Jin-Neuron/EleMagHarmony/Hardware/F303K8/EleMagDriver/pic/v3.0/schematic.jpg

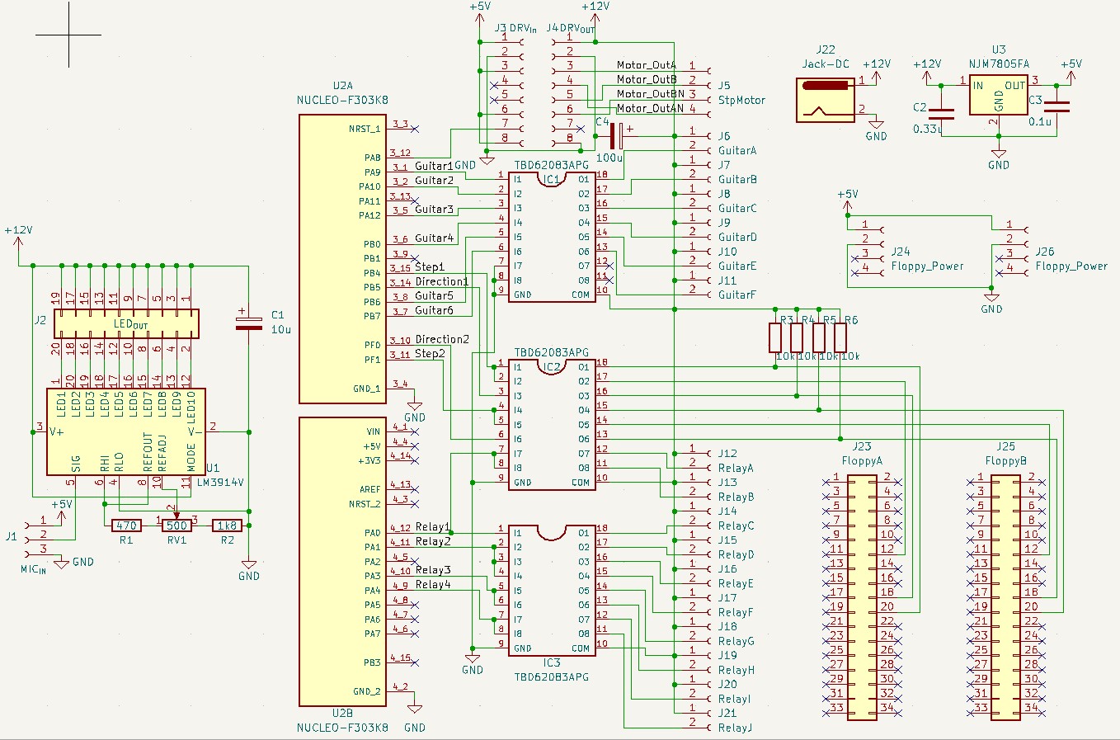
Hardware/F303K8/EleMagDriver/pic/v3.0/schematic.jpg
