Jin-Neuron/EleMagHarmony/Hardware/F303K8/F303K8PinOut/Board.jpg

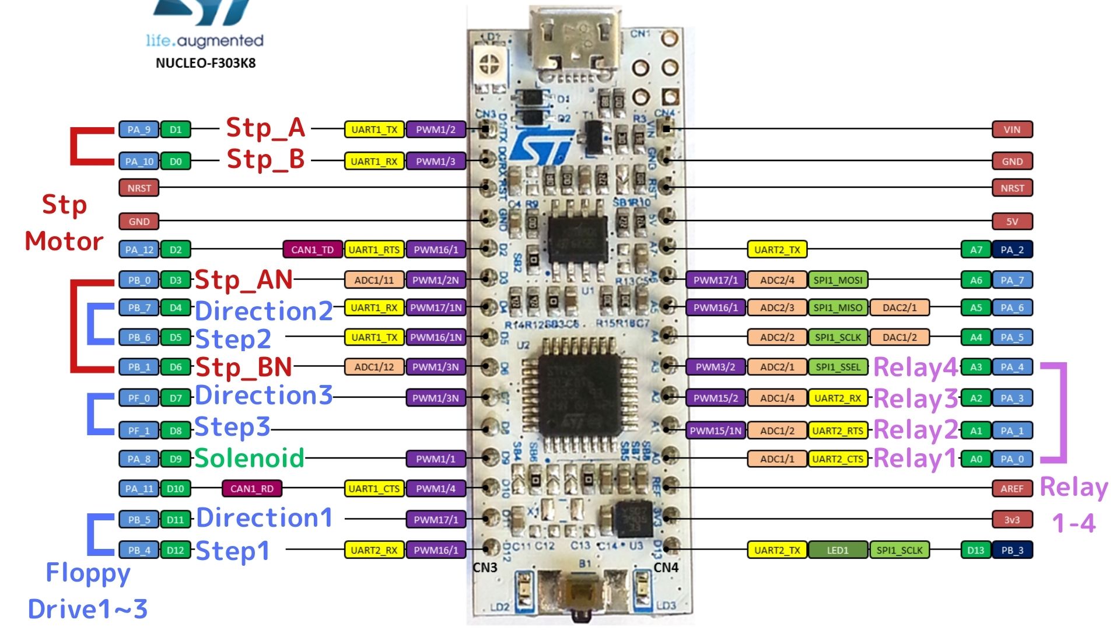
Hardware/F303K8/F303K8PinOut/Board.jpg
