Jin-Neuron/EleMagHarmony/Hardware/F303K8/F303K8PinOut/MCU.jpg

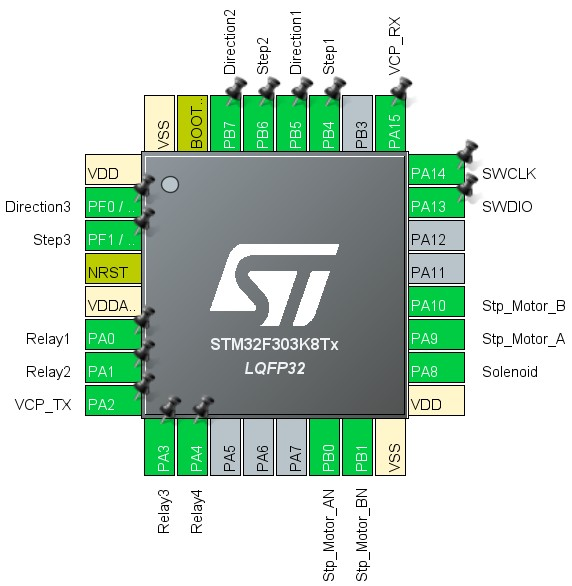
Hardware/F303K8/F303K8PinOut/MCU.jpg
