Jin-Neuron/EleMagHarmony/Hardware/F401RE/F401REPinOut/Left.jpg

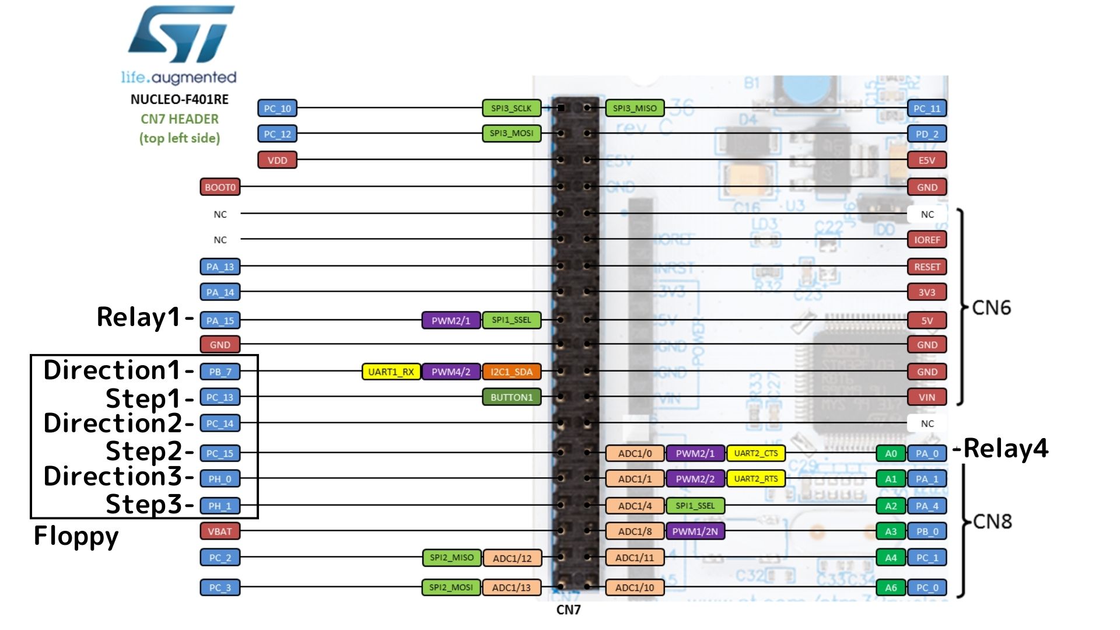
Hardware/F401RE/F401REPinOut/Left.jpg
