Jin-Neuron/EleMagHarmony/Hardware/F401RE/F401REPinOut/MCU.jpg

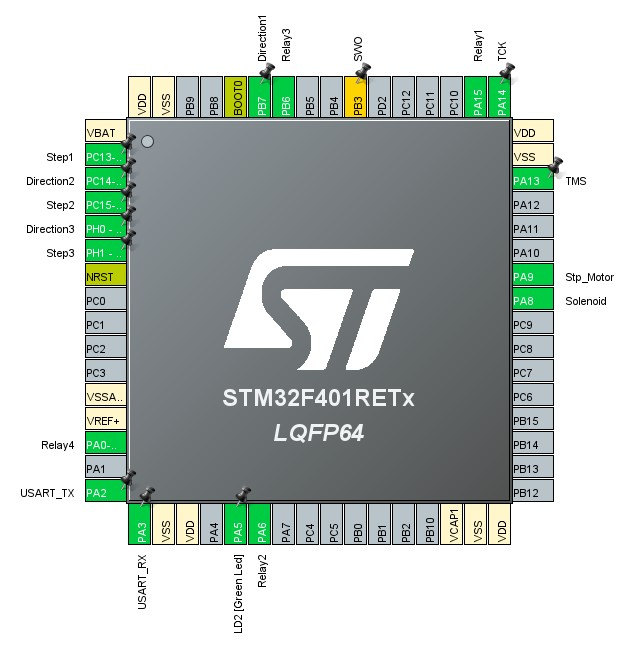
Hardware/F401RE/F401REPinOut/MCU.jpg
