Jin-Neuron/EleMagHarmony/Hardware/F401RE/F401REPinOut/Right.jpg

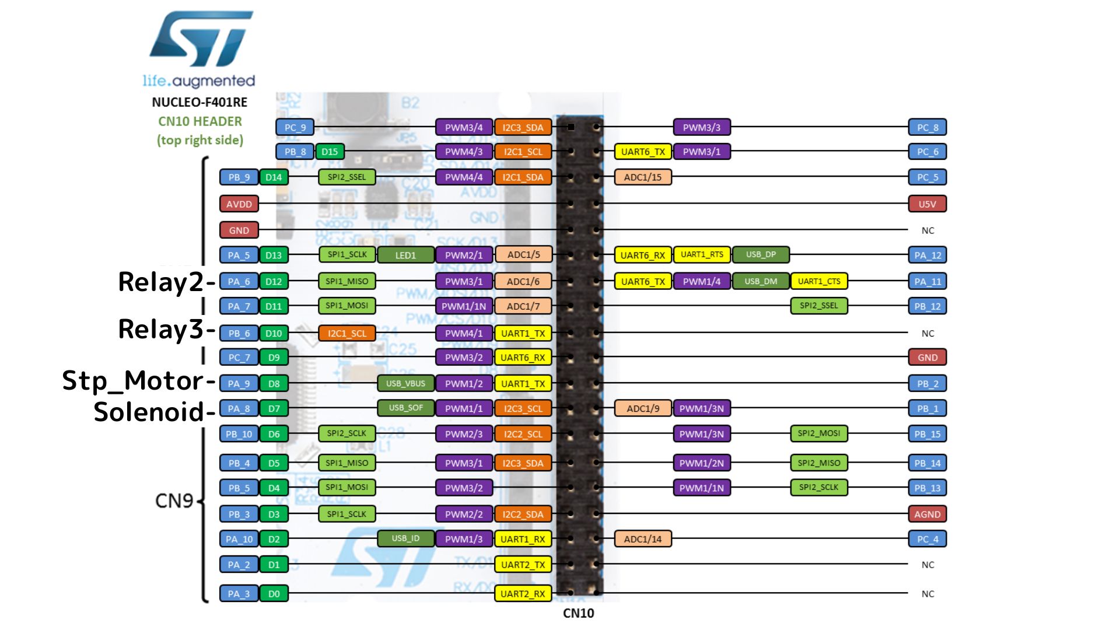
Hardware/F401RE/F401REPinOut/Right.jpg
