Jin-Neuron/EleMagHarmony/pic/Guitar.jpg

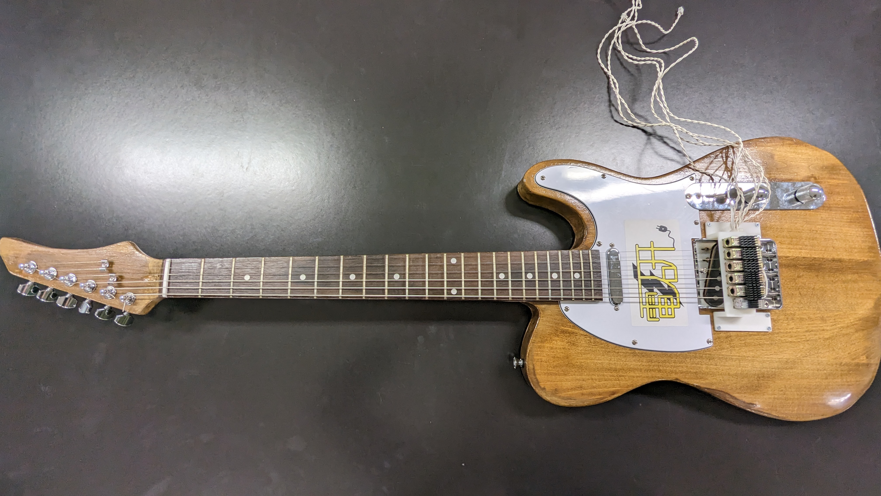
pic/Guitar.jpg
