Jin-Neuron/EleMagHarmony/Hardware/Guitar/SolenoidMount.stl

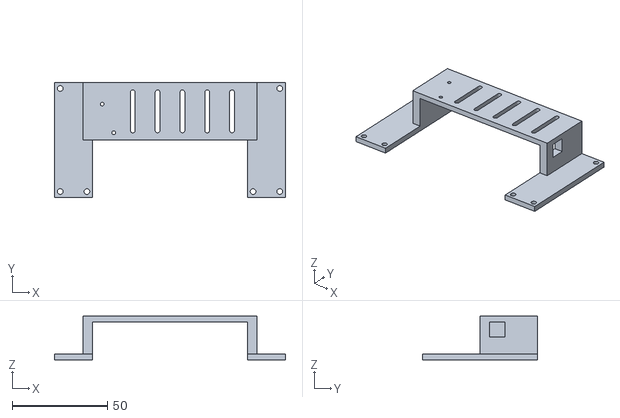
[picture p13: CAD file, 2023-10-04]
Hardware/Guitar/SolenoidMount.stl
121.0 x 60.0 x 23.0
