Jin-Neuron/EleMagHarmony/Hardware/F303K8/EleMagDriver/EleMagDriver.kicad_pcb

## KiCad design Hardware/F303K8/EleMagDriver/EleMagDriver.kicad_pcb (2023-10-03)

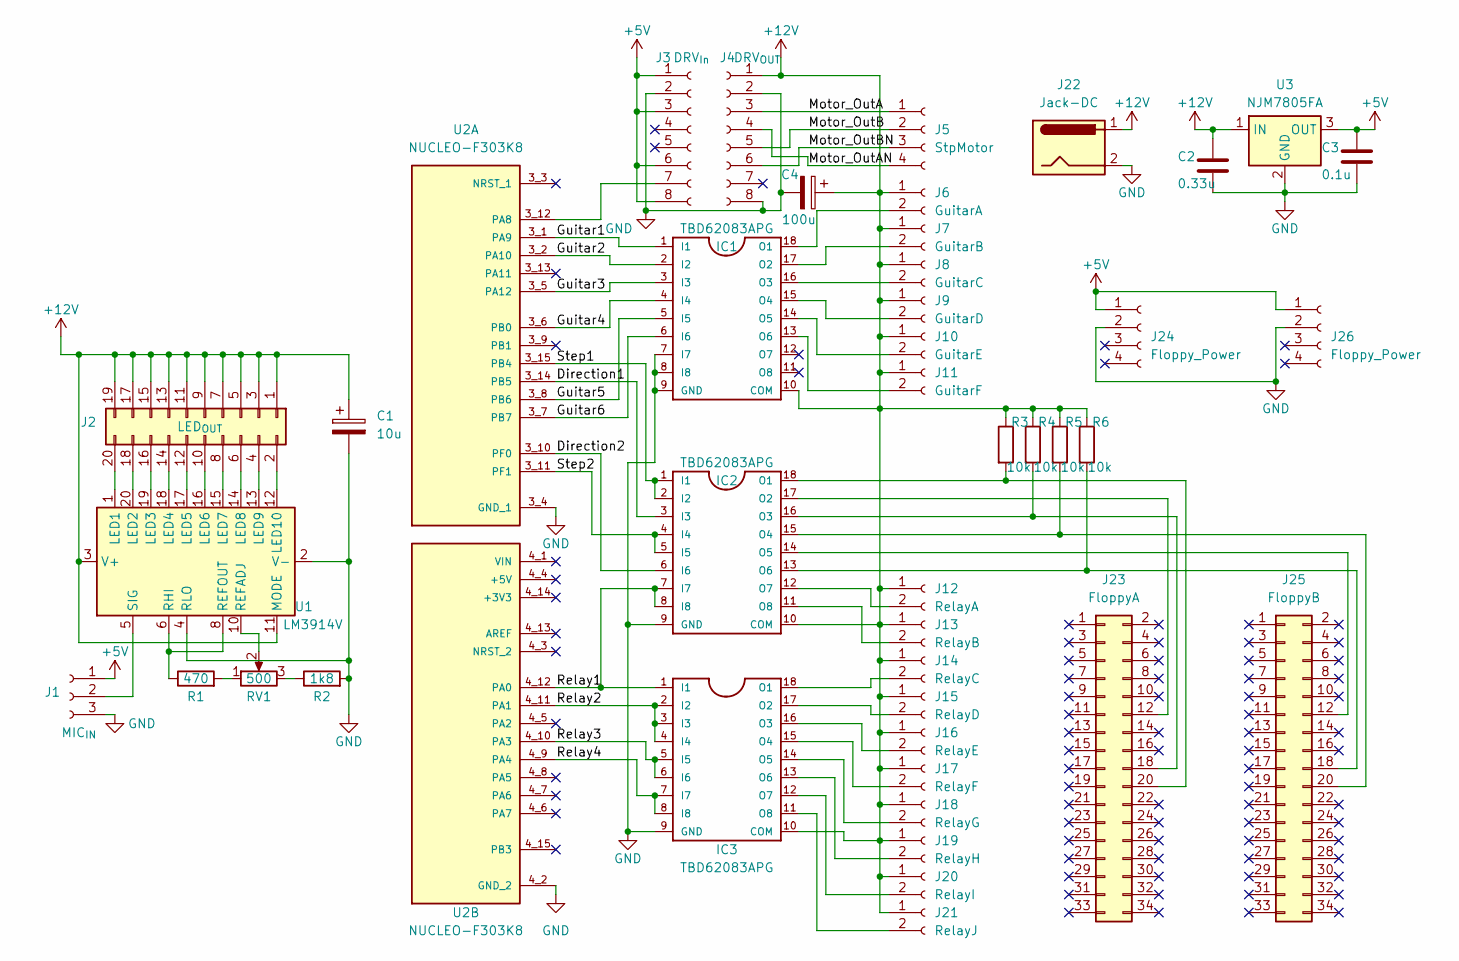
[picture p14: schematic EleMagDriver.kicad_sch]

Parts:
C1: 10u; CP_Radial_D5.0mm_P2.00mm
C2: 0.33u; C_Disc_D4.7mm_W2.5mm_P5.00mm
C3: 0.1u; C_Disc_D4.7mm_W2.5mm_P5.00mm
C4: 100u; CP_Radial_D6.3mm_P2.50mm
IC1, IC2, IC3: TBD62083APG; DIP-18_W7.62mm
J1: MIC_{IN}; PinSocket_1x03_P2.54mm_Vertical
J2: LED_{OUT}; PinHeader_2x10_P2.54mm_Vertical
J3: DRV_{In}; PinSocket_1x08_P2.54mm_Vertical
J4: DRV_{OUT}; PinSocket_1x08_P2.54mm_Vertical
J5: StpMotor; JST_XH_S4B-XH-A_1x04_P2.50mm_Horizontal
J6: GuitarA; JST_XH_S2B-XH-A_1x02_P2.50mm_Horizontal
J7: GuitarB; JST_XH_S2B-XH-A_1x02_P2.50mm_Horizontal
J8: GuitarC; JST_XH_S2B-XH-A_1x02_P2.50mm_Horizontal
J9: GuitarD; JST_XH_S2B-XH-A_1x02_P2.50mm_Horizontal
J10: GuitarE; JST_XH_S2B-XH-A_1x02_P2.50mm_Horizontal
J11: GuitarF; JST_XH_S2B-XH-A_1x02_P2.50mm_Horizontal
J12: RelayA; JST_XH_B2B-XH-A_1x02_P2.50mm_Vertical
J13: RelayB; JST_XH_B2B-XH-A_1x02_P2.50mm_Vertical
J14: RelayC; JST_XH_B2B-XH-A_1x02_P2.50mm_Vertical
J15: RelayD; JST_XH_B2B-XH-A_1x02_P2.50mm_Vertical
J16: RelayE; JST_XH_B2B-XH-A_1x02_P2.50mm_Vertical
J17: RelayF; JST_XH_B2B-XH-A_1x02_P2.50mm_Vertical
J18: RelayG; JST_XH_B2B-XH-A_1x02_P2.50mm_Vertical
J19: RelayH; JST_XH_B2B-XH-A_1x02_P2.50mm_Vertical
J20: RelayI; JST_XH_B2B-XH-A_1x02_P2.50mm_Vertical
J21: RelayJ; JST_XH_B2B-XH-A_1x02_P2.50mm_Vertical
J22: Jack-DC; BarrelJack_Horizontal
J23: FloppyA; SHDR34W70P254_2X17_5050X820X900P
J24, J26: Floppy_Power; PinHeader_1x04_P2.54mm_Horizontal
J25: FloppyB; SHDR34W70P254_2X17_5050X820X900P
R1: 470; R_Axial_DIN0207_L6.3mm_D2.5mm_P10.16mm_Horizontal
R2: 1k8; R_Axial_DIN0207_L6.3mm_D2.5mm_P10.16mm_Horizontal
R3, R4, R5, R6: 10k; R_Axial_DIN0207_L6.3mm_D2.5mm_P10.16mm_Horizontal
RV1: 500; Potentiometer_Bourns_3386P_Vertical
U1: LM3914V; PLCC-20
U2: NUCLEO-F303K8; MODULE_NUCLEO-F303K8; PARTREV 5
U3: NJM7805FA; TO-220-3_Vertical

Connections:
+5V: C3.1, J1.1, J3.1, J3.3, J3.6, J3.8, J24.1, J26.1, U3.3 (OUT)
+12V: C1.1, C2.1, C4.1, IC1.10 (COM), IC2.10 (COM), IC3.10 (COM), J2.1, J2.3, J2.5, J2.7, J2.9, J2.11, J2.13, J2.15, J2.17, J2.19, J4.1, J6.1, J7.1, J8.1, J9.1, J10.1, J11.1, J12.1, J13.1, J14.1, J15.1, J16.1, J17.1, J18.1, J19.1, J20.1, J21.1, J22.1, R3.1, R4.1, R5.1, R6.1, U1.3 (V+), U1.11 (MODE), U3.1 (IN)
/Direction1: IC2.3 (I3), U2.3_14 (PB5)
/Direction2: IC2.6 (I6), U2.3_10 (PF0)
/Guitar1: IC1.1 (I1), U2.3_1 (PA9)
/Guitar2: IC1.2 (I2), U2.3_2 (PA10)
/Guitar3: IC1.3 (I3), U2.3_5 (PA12)
/Guitar4: IC1.4 (I4), U2.3_6 (PB0)
/Guitar5: IC1.5 (I5), U2.3_8 (PB6)
/Guitar6: IC1.6 (I6), U2.3_7 (PB7)
/Motor_OutA: J4.3, J5.1
/Motor_OutAN: J4.4, J5.4
/Motor_OutB: J4.5, J5.2
/Motor_OutBN: J4.6, J5.3
/Relay1: IC2.7 (I7), IC2.8 (I8), IC3.1 (I1), U2.4_12 (PA0)
/Relay2: IC3.2 (I2), IC3.3 (I3), IC3.4 (I4), U2.4_11 (PA1)
/Relay3: IC3.5 (I5), IC3.6 (I6), U2.4_10 (PA3)
/Relay4: IC3.7 (I7), IC3.8 (I8), U2.4_9 (PA4)
/Step1: IC2.1 (I1), IC2.2 (I2), U2.3_15 (PB4)
/Step2: IC2.4 (I4), IC2.5 (I5), U2.3_11 (PF1)
GND: C1.2, C2.2, C3.2, C4.2, IC1.7 (I7), IC1.8 (I8), IC1.9 (GND), IC2.9 (GND), IC3.9 (GND), J1.3, J3.2, J4.2, J4.8, J22.2, J24.2, J26.2, R2.2, U1.2 (V-), U1.4 (RLO), U2.3_4 (GND_1), U2.4_2 (GND_2), U3.2 (GND)
unnamed: IC1.18 (O1), J6.2
unnamed: IC1.17 (O2), J7.2
unnamed: IC1.16 (O3), J8.2
unnamed: IC1.15 (O4), J9.2
unnamed: IC1.14 (O5), J10.2
unnamed: IC1.13 (O6), J11.2
unnamed: IC2.18 (O1), J23.20, R3.2
unnamed: IC2.17 (O2), J23.12
unnamed: IC2.16 (O3), J23.18, R4.2
unnamed: IC2.15 (O4), J25.20, R5.2
unnamed: IC2.14 (O5), J25.12
unnamed: IC2.13 (O6), J25.18, R6.2
unnamed: IC2.12 (O7), J12.2
unnamed: IC2.11 (O8), J13.2
unnamed: IC3.18 (O1), J14.2
unnamed: IC3.17 (O2), J15.2
unnamed: IC3.16 (O3), J16.2
unnamed: IC3.15 (O4), J17.2
unnamed: IC3.14 (O5), J18.2
unnamed: IC3.13 (O6), J19.2
unnamed: IC3.12 (O7), J20.2
unnamed: IC3.11 (O8), J21.2
unnamed: J1.2, U1.5 (SIG)
unnamed: J2.2, U1.12 (LED10)
unnamed: J2.4, U1.13 (LED9)
unnamed: J2.6, U1.14 (LED8)
unnamed: J2.8, U1.15 (LED7)
unnamed: J2.10, U1.16 (LED6)
unnamed: J2.12, U1.17 (LED5)
unnamed: J2.14, U1.18 (LED4)
unnamed: J2.16, U1.19 (LED3)
unnamed: J2.18, U1.20 (LED2)
unnamed: J2.20, U1.1 (LED1)
unnamed: J3.7, U2.3_12 (PA8)
unnamed: R1.2, RV1.1
unnamed: R2.1, RV1.3
unnamed: RV1.2, U1.10 (REFADJ)
unnamed: R1.1, U1.6 (RHI), U1.8 (REFOUT)

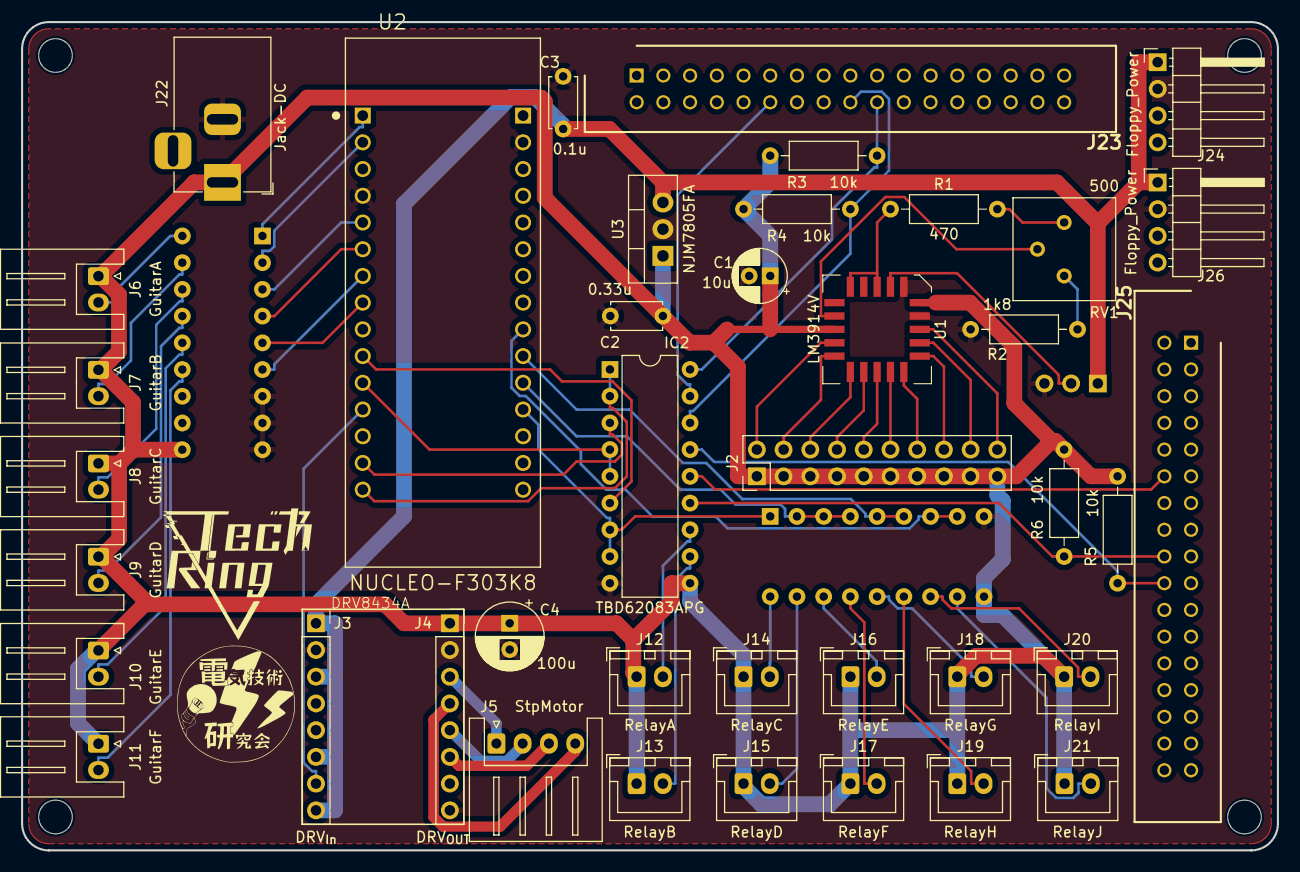
[picture p15: board EleMagDriver.kicad_pcb from above]

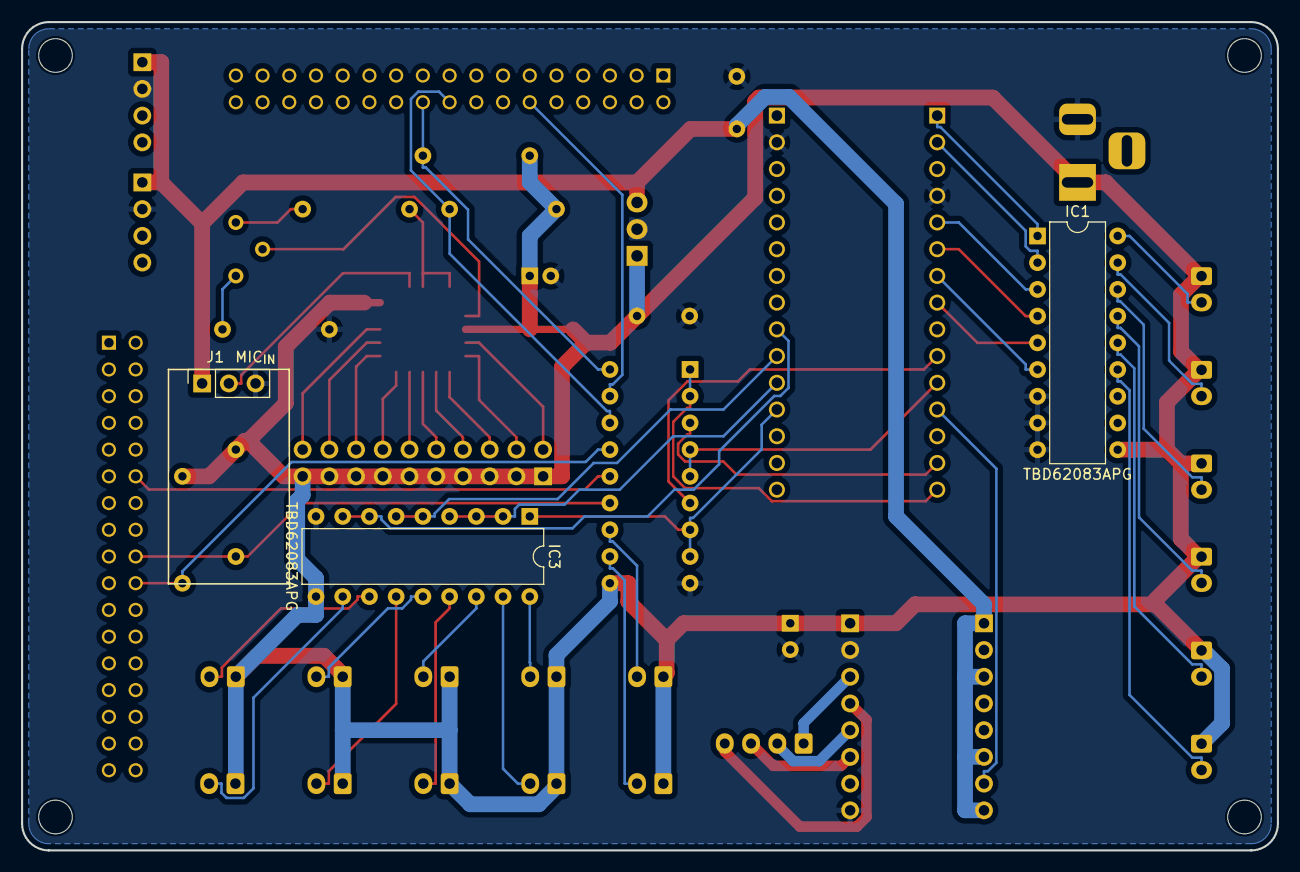
[picture p16: board EleMagDriver.kicad_pcb from below]

Board: 2 copper layers, 119.4 x 78.7 mm, 45 parts (3 on the bottom side), 59 nets.

Other parts of the board:
G0: LOGO; TechRing
G1: LOGO; Denken
