Jin-Neuron/EleMagHarmony/Hardware/F303K8/EleMagDriver/SoundLevelMater/SoundLevelMater.kicad_pcb

## KiCad design Hardware/F303K8/EleMagDriver/SoundLevelMater/SoundLevelMater.kicad_pcb (2023-08-28)

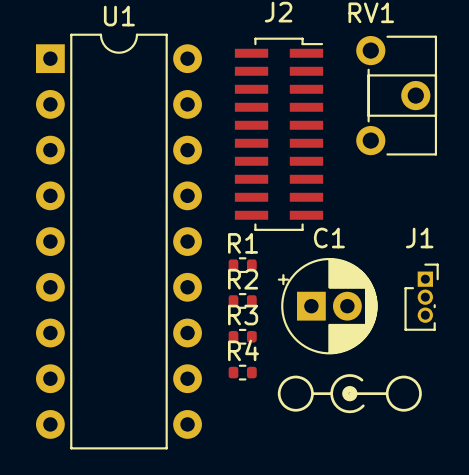
[picture p17: board SoundLevelMater.kicad_pcb from above]

Board: 2 copper layers, 10 parts (0 on the bottom side), 8 nets, no tracks yet.

Parts:
C1: C_Polarized; CP_Radial_D5.0mm_P2.00mm
J1: Conn_01x03_Socket; PinSocket_1x03_P1.00mm_Vertical
J2: Conn_02x10_Row_Letter_Last; PinSocket_2x10_P1.00mm_Vertical_SMD
J3: Barrel_Jack; Symbol_Barrel_Polarity
R1, R2, R3, R4: R; R_0402_1005Metric
RV1: R_Potentiometer; Potentiometer_ACP_CA6-H2,5_Horizontal
U1: LM3914N; DIP-18_W7.62mm

Connections:
+5V: C1.1, J1.1, U1.3 (V+), U1.9 (MODE)
GND: C1.2, J1.2, R3.2, R4.2, U1.2 (V-), U1.4 (RLO)
unnamed: J1.3, R2.1
unnamed: R1.2, RV1.1
unnamed: R3.1, RV1.3
unnamed: RV1.2, U1.8 (REFADJ)
unnamed: R1.1, U1.6 (RHI), U1.7 (REFOUT)
unnamed: R2.2, R4.1, U1.5 (SIG)
