Jin-Neuron/EleMagHarmony/Hardware/F401RE/401REFirm/Core/Src/main.c

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
/* Includes ------------------------------------------------------------------*/
#include "main.h"

/* USER CODE BEGIN Includes */
#include <math.h>
#include <stdlib.h>
/* USER CODE END Includes */

/* USER CODE BEGIN PD */
#define TimerNum 8
#define FloppyNum 6
/* USER CODE END PD */

TIM_HandleTypeDef htim1;
TIM_HandleTypeDef htim2;
TIM_HandleTypeDef htim3;
TIM_HandleTypeDef htim4;
TIM_HandleTypeDef htim5;
TIM_HandleTypeDef htim9;
TIM_HandleTypeDef htim10;
TIM_HandleTypeDef htim11;

UART_HandleTypeDef huart2;

/* USER CODE BEGIN PV */
GPIO_PinState currentState = GPIO_PIN_RESET;
uint8_t currentPosition = 0;
uint8_t isTimer1Counting = 0;

char dataLength[8];
char data[255];
char length[10];
uint8_t uartCnt = 0;
uint64_t dataLen;
uint16_t notes[10] = {0};
uint16_t freqs[10] = {0};
double tmp[10] = {0};

const double timer_clock = 84e6;
const uint8_t timerPeriod = 100;

uint8_t arrayLen = 0;
GPIO_TypeDef* floppyPort[FloppyNum] = {};
uint32_t floppyPin[FloppyNum] = {};
TIM_HandleTypeDef times[TimerNum] = {};
/* USER CODE END PV */

void SystemClock_Config(void);
static void MX_GPIO_Init(void);
static void MX_USART2_UART_Init(void);
static void MX_TIM1_Init(void);
static void MX_TIM2_Init(void);
static void MX_TIM3_Init(void);
static void MX_TIM4_Init(void);
static void MX_TIM5_Init(void);
static void MX_TIM9_Init(void);
static void MX_TIM10_Init(void);
static void MX_TIM11_Init(void);
/* USER CODE BEGIN 0 */

//reset position of floppy
void resetStep(){
	for(uint8_t i = 0; i < FloppyNum; i+=2){
		//i : Direction, i+1 : Step
		LL_GPIO_SetOutputPin(floppyPort[i], floppyPin[i]);
		for(uint8_t j = 0; j < 79; j++){
			LL_GPIO_SetOutputPin(floppyPort[i+1], floppyPin[i+1]);
			LL_GPIO_ResetOutputPin(floppyPort[i+1], floppyPin[i+1]);
		}
		currentPosition = 0;
		LL_GPIO_ResetOutputPin(floppyPort[i], floppyPin[i]);
	}
}


//Timer interrupt (floppy control only)
void HAL_TIM_PeriodElapsedCallback(TIM_HandleTypeDef *htim)
{
	uint8_t timerIdx = 0;
	for(; timerIdx < TimerNum; timerIdx++){
		if(htim == &times[timerIdx])
			break;
	}
	if(timerIdx >= 5){
		//Update position
		//timer : 5 --> floppy : 0, 1
		//timer : 6 --> floppy : 2, 3
		//timer : 7 --> floppy : 4, 5
		if(currentState == GPIO_PIN_SET){
			if(--currentPosition <= 0){
				currentState = GPIO_PIN_RESET;
				LL_GPIO_ResetOutputPin(floppyPort[(timerIdx - 5) * 2], floppyPin[(timerIdx - 5) * 2]);
			}
		}else if(++currentPosition >= 158){
			currentState = GPIO_PIN_SET;
			LL_GPIO_SetOutputPin(floppyPort[(timerIdx - 5) * 2], floppyPin[(timerIdx - 5) * 2]);
		}
		LL_GPIO_TogglePin(floppyPort[(timerIdx - 5) * 2 + 1], floppyPin[(timerIdx - 5) * 2 + 1]);
	}
}

//Set frequency of Timer
void setTimer(uint8_t part, TIM_HandleTypeDef htim, uint32_t prescaler){

  if(prescaler < 0) prescaler = 799;

  htim.Instance = htim.Instance;
  htim.Init.Prescaler = prescaler;
  htim.Init.CounterMode = TIM_COUNTERMODE_UP;
  htim.Init.Period = timerPeriod - 1;	//because of start with 0
  htim.Init.ClockDivision = TIM_CLOCKDIVISION_DIV1;

	if(part < 5){
		TIM_OC_InitTypeDef sConfigOC = {0};	//pwm setting only
	  HAL_TIM_PWM_Init(&htim);

	  sConfigOC.OCMode = TIM_OCMODE_PWM1;
	  sConfigOC.Pulse = 50;
	  //set duty
	  sConfigOC.OCPolarity = TIM_OCPOLARITY_HIGH;
	  sConfigOC.OCFastMode = TIM_OCFAST_DISABLE;
	  sConfigOC.OCIdleState = TIM_OCIDLESTATE_RESET;
	  sConfigOC.OCNIdleState = TIM_OCNIDLESTATE_RESET;
	  HAL_TIM_PWM_ConfigChannel(&htim, &sConfigOC, TIM_CHANNEL_1);
	  HAL_TIM_PWM_ConfigChannel(&htim, &sConfigOC, TIM_CHANNEL_2);

	  //start
	  HAL_TIM_PWM_Start(&htim, TIM_CHANNEL_1);
	  HAL_TIM_PWM_Start(&htim, TIM_CHANNEL_2);	//stp_motor only

	}else{
	  HAL_TIM_Base_Init(&htim);
	  // start
	  HAL_TIM_Base_Start_IT(&htim);
	}

}

//Convert note number to frequency
float NoteConvert(uint16_t noteNum){
	int64_t tmp = noteNum - 69;
	double exp = (double)tmp / 12.0;
	double freq = 440 * pow(2.0, exp);
	return (float)freq;
}

//Serial interrupt
void HAL_UART_RxCpltCallback(UART_HandleTypeDef *huart)
{
	if(uartCnt){
		uint8_t part = 0;
		uint64_t lastIdx = 0;
		for(uint64_t i = 0; i < dataLen; i++){
			uint8_t Idx = i - lastIdx;
			data[i] &= 0x0f;
			if(Idx < 4){
				part |= data[i] << (3 - Idx);
			}else if(Idx < 5){
				if(data[i] == 0){
					lastIdx = i + 1;
					freqs[part] = 0;
					notes[part] = 0;
					if(part < TimerNum){
						if(part < 5)
							HAL_TIM_Base_Stop_IT(&times[part]);
						else{
							HAL_TIM_PWM_Stop(&times[part], TIM_CHANNEL_1);
							HAL_TIM_PWM_Stop(&times[part], TIM_CHANNEL_2);	//stp_motor only
						}
					}
					part = 0;
				}
			}else if(Idx < 13){
				notes[part] |= data[i] << (12 - Idx);
			}else{
				freqs[part] = (uint16_t)NoteConvert(notes[part]);
				if(part < TimerNum){
					//double the frequency if it is floppy
					if(part >= 5)
						freqs[part] *= 2;
					setTimer(part, times[part], (timer_clock / (freqs[part] * timerPeriod) - 1));
				}
				lastIdx = i;
				part = 0;
			}
			if(i == dataLen - 1){
				freqs[part] = (uint16_t)NoteConvert(notes[part]);
				if(part < TimerNum){
					//double the frequency if it is floppy
					if(part >= 5)
						freqs[part] *= 2;
					setTimer(part, times[part], (timer_clock / (freqs[part] * timerPeriod) - 1));
				}
				if(Idx < 5){
					lastIdx = i + 1;
					freqs[part] = 0;
					notes[part] = 0;
					if(part < TimerNum){
						if(part < 5)
							HAL_TIM_Base_Stop_IT(&times[part]);
						else{
							HAL_TIM_PWM_Stop(&times[part], TIM_CHANNEL_1);
							HAL_TIM_PWM_Stop(&times[part], TIM_CHANNEL_2);	//stp_motor only
						}
					}
					part = 0;
				}
			}
		}
		uartCnt = 0;
		HAL_UART_Receive_IT(&huart2, (uint8_t *)dataLength, 8);
		return;
	}
	dataLen = 0;
	for(uint8_t i = 0; i < 8; i++){
		dataLength[i] &= 0x0f;
		dataLen |= dataLength[i] << (7 - i);
	}
	HAL_UART_Receive_IT(&huart2, (uint8_t *)data, dataLen);
	uartCnt++;
}

/* USER CODE END 0 */

/**
  * @brief  The application entry point.
  * @retval int
  */
int main(void)
{
  /* MCU Configuration--------------------------------------------------------*/

  /* Reset of all peripherals, Initializes the Flash interface and the Systick. */
  HAL_Init();

  /* Configure the system clock */
  SystemClock_Config();

  /* Initialize all configured peripherals */
  MX_GPIO_Init();
  MX_USART2_UART_Init();
  MX_TIM1_Init();
  MX_TIM2_Init();
  MX_TIM3_Init();
  MX_TIM4_Init();
  MX_TIM5_Init();
  MX_TIM9_Init();
  MX_TIM10_Init();
  MX_TIM11_Init();
  /* USER CODE BEGIN 2 */

  //floppy1 --> 0 : direction, 1 : step
  //floppy2 --> 2 : direction, 3 : step
  //floppy3 --> 4 : direction, 5 : step
  floppyPort[0] = Direction1_GPIO_Port;
  floppyPort[1] = Step1_GPIO_Port;
  floppyPort[2] = Direction2_GPIO_Port;
  floppyPort[3] = Step2_GPIO_Port;
  floppyPort[4] = Direction3_GPIO_Port;
  floppyPort[5] = Step3_GPIO_Port;
  floppyPin[0] = Direction1_Pin;
  floppyPin[1] = Step1_Pin;
  floppyPin[2] = Direction2_Pin;
  floppyPin[3] = Step2_Pin;
  floppyPin[4] = Direction3_Pin;
  floppyPin[5] = Step3_Pin;

  //Melody by Solenoid and Stp_Motor
  times[0] = htim1;
  //Drum by Relay
  times[1] = htim2;
  times[2] = htim3;
  times[3] = htim4;
  times[4] = htim5;
  //Base by FloppyDrive
  times[5] = htim9;
  times[6] = htim10;
  times[7] = htim11;

  //reset floppy
  resetStep();
  //start UART interrupt
  HAL_UART_Receive_IT(&huart2, (uint8_t *)dataLength, 8);

  /* USER CODE END 2 */

  /* Infinite loop */
  /* USER CODE BEGIN WHILE */
  while (1)
  {
    /* USER CODE END WHILE */

    /* USER CODE BEGIN 3 */
  }
  /* USER CODE END 3 */
}

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
