Jin-Neuron/EleMagHarmony/Hardware/F303K8/303K8Firm/Core/Inc/main.h

#define Direction2_Pin GPIO_PIN_0
#define Direction2_GPIO_Port GPIOF
#define Step2_Pin GPIO_PIN_1
#define Step2_GPIO_Port GPIOF
#define Relay1_Pin GPIO_PIN_0
#define Relay1_GPIO_Port GPIOA
#define Relay2_Pin GPIO_PIN_1
#define Relay2_GPIO_Port GPIOA
#define VCP_TX_Pin GPIO_PIN_2
#define VCP_TX_GPIO_Port GPIOA
#define Relay3_Pin GPIO_PIN_3
#define Relay3_GPIO_Port GPIOA
#define Relay4_Pin GPIO_PIN_4
#define Relay4_GPIO_Port GPIOA
#define Guitar4_Pin GPIO_PIN_0
#define Guitar4_GPIO_Port GPIOB
#define StpMotor_Pin GPIO_PIN_8
#define StpMotor_GPIO_Port GPIOA
#define Guitar1_Pin GPIO_PIN_9
#define Guitar1_GPIO_Port GPIOA
#define Guitar2_Pin GPIO_PIN_10
#define Guitar2_GPIO_Port GPIOA
#define Guitar3_Pin GPIO_PIN_12
#define Guitar3_GPIO_Port GPIOA
#define SWDIO_Pin GPIO_PIN_13
#define SWDIO_GPIO_Port GPIOA
#define SWCLK_Pin GPIO_PIN_14
#define SWCLK_GPIO_Port GPIOA
#define VCP_RX_Pin GPIO_PIN_15
#define VCP_RX_GPIO_Port GPIOA
#define Step1_Pin GPIO_PIN_4
#define Step1_GPIO_Port GPIOB
#define Direction1_Pin GPIO_PIN_5
#define Direction1_GPIO_Port GPIOB
#define Guitar5_Pin GPIO_PIN_6
#define Guitar5_GPIO_Port GPIOB
#define Guitar6_Pin GPIO_PIN_7
#define Guitar6_GPIO_Port GPIOB
