Jin-Neuron/EleMagHarmony/Hardware/F303K8/303K8Firm/Core/Src/main.c

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
/* Includes ------------------------------------------------------------------*/
#include "main.h"

/* USER CODE BEGIN Includes */
#include <math.h>
#include <stdlib.h>
/* USER CODE END Includes */

/* USER CODE BEGIN PD */
#define TimerNum 8
#define FloppyNum 2
#define RelayNum 4
#define GuitarNum 6
/* USER CODE END PD */

TIM_HandleTypeDef htim1;
TIM_HandleTypeDef htim2;
TIM_HandleTypeDef htim3;
TIM_HandleTypeDef htim6;
TIM_HandleTypeDef htim7;
TIM_HandleTypeDef htim15;
TIM_HandleTypeDef htim16;
TIM_HandleTypeDef htim17;

UART_HandleTypeDef huart2;

/* USER CODE BEGIN PV */
GPIO_PinState currentState[FloppyNum] ={ GPIO_PIN_RESET};
uint8_t currentPosition[FloppyNum] = {0};

char data[256];
uint8_t uartCnt = 0;
uint16_t notes[12] = {0};
uint16_t freqs[12] = {0};
uint16_t noteParFreq[127] = {0};
double tmp[12] = {0};

const double timer_clock = 64e6;
const uint8_t timerPeriod = 100;

uint8_t arrayLen = 0;
GPIO_TypeDef* relayPort[RelayNum] = {};
uint32_t relayPin[RelayNum] = {};
GPIO_TypeDef* floppyPort[FloppyNum * 2] = {};
uint32_t floppyPin[FloppyNum * 2] = {};
GPIO_TypeDef* guitarPort[GuitarNum] = {};
uint32_t guitarPin[GuitarNum] = {};
TIM_HandleTypeDef times[TimerNum] = {};
/* USER CODE END PV */

void SystemClock_Config(void);
static void MX_GPIO_Init(void);
static void MX_USART2_UART_Init(void);
static void MX_TIM1_Init(void);
static void MX_TIM6_Init(void);
static void MX_TIM7_Init(void);
static void MX_TIM17_Init(void);
static void MX_TIM2_Init(void);
static void MX_TIM3_Init(void);
static void MX_TIM15_Init(void);
static void MX_TIM16_Init(void);
/* USER CODE BEGIN 0 */
//reset position of floppy
void resetStep(){
	for(uint8_t i = 0; i < FloppyNum * 2; i+=2){
		//i : Direction, i+1 : Step
		HAL_GPIO_WritePin(floppyPort[i], floppyPin[i], GPIO_PIN_SET);
		for(uint8_t j = 0; j < 79; j++){
			HAL_GPIO_WritePin(floppyPort[i+1], floppyPin[i+1], GPIO_PIN_SET);
			HAL_GPIO_WritePin(floppyPort[i+1], floppyPin[i+1], GPIO_PIN_RESET);
			HAL_Delay(10);
		}
		currentPosition[i / 2] = 0;
		currentState[i / 2] = GPIO_PIN_RESET;
		HAL_GPIO_WritePin(floppyPort[i], floppyPin[i], GPIO_PIN_RESET);
	}
}

//Timer interrupt (floppy control only)
void HAL_TIM_PeriodElapsedCallback(TIM_HandleTypeDef *htim)
{
	uint8_t timerIdx = 0;
	for(; timerIdx < TimerNum; timerIdx++){
		if(htim->Instance == times[timerIdx].Instance)
			break;
	}
	//timer0 -> StpMotor(Melody)
	//timer1-6 -> GuitaNoid(Guitar)
	//timer7 -> FloppyDrive(Base)
	if(timerIdx == 7){
		//Update position
		for(uint8_t floppyIdx = timerIdx - 7; floppyIdx < FloppyNum; floppyIdx++){
			currentPosition[floppyIdx] = (currentState[floppyIdx] == GPIO_PIN_SET) ? currentPosition[floppyIdx] - 1 : currentPosition[floppyIdx] + 1;
			if(currentPosition[floppyIdx] <= 0){
				currentState[floppyIdx] = GPIO_PIN_RESET;
				HAL_GPIO_WritePin(floppyPort[floppyIdx * 2], floppyPin[floppyIdx * 2], currentState[floppyIdx]);
			}else if(currentPosition[floppyIdx] >= 158){
				currentState[floppyIdx] = GPIO_PIN_SET;
				HAL_GPIO_WritePin(floppyPort[floppyIdx * 2], floppyPin[floppyIdx * 2], currentState[floppyIdx]);
			}
			HAL_GPIO_TogglePin(floppyPort[floppyIdx * 2 + 1], floppyPin[floppyIdx * 2 + 1]);
		}
	}else if(timerIdx > 0){
		uint8_t guitarIdx = timerIdx - 1;
		HAL_GPIO_TogglePin(guitarPort[guitarIdx], guitarPin[guitarIdx]);
	}
}

//Set frequency of Timer
void setTimer(uint8_t part, TIM_HandleTypeDef htim, uint32_t prescaler, uint32_t pwm){

  if(pwm > 99) pwm = 99;
  if(prescaler < 0) prescaler = 799;

  htim.Instance = htim.Instance;
  htim.Init.Prescaler = prescaler;
  htim.Init.CounterMode = TIM_COUNTERMODE_UP;
  htim.Init.Period = timerPeriod - 1;	//because of start with 0
  htim.Init.ClockDivision = TIM_CLOCKDIVISION_DIV1;
  htim.Init.AutoReloadPreload = TIM_AUTORELOAD_PRELOAD_ENABLE;
  HAL_TIM_Base_Init(&htim);

	if(part < 1){
	  TIM_OC_InitTypeDef sConfigOC = {0};	//pwm setting only

	  sConfigOC.OCMode = TIM_OCMODE_PWM1;
	  sConfigOC.Pulse = pwm;
	  sConfigOC.OCPolarity = TIM_OCPOLARITY_HIGH;
	  sConfigOC.OCFastMode = TIM_OCFAST_DISABLE;
	  sConfigOC.OCIdleState = TIM_OCIDLESTATE_RESET;
	  sConfigOC.OCNIdleState = TIM_OCNIDLESTATE_RESET;
	  HAL_TIM_PWM_ConfigChannel(&htim, &sConfigOC, TIM_CHANNEL_1);

	  //start
	  HAL_TIM_PWM_Start(&htim, TIM_CHANNEL_1);

	  /*sConfigOC.OCMode = TIM_OCMODE_TOGGLE;
	  sConfigOC.Pulse = 0;
	  sConfigOC.OCPolarity = TIM_OCPOLARITY_HIGH;
	  sConfigOC.OCNPolarity = TIM_OCNPOLARITY_HIGH;
	  sConfigOC.OCFastMode = TIM_OCFAST_DISABLE;
	  sConfigOC.OCIdleState = TIM_OCIDLESTATE_RESET;
	  sConfigOC.OCNIdleState = TIM_OCNIDLESTATE_RESET;

	  HAL_TIM_OC_ConfigChannel(&htim, &sConfigOC, TIM_CHANNEL_2);
	  HAL_TIM_OC_Start(&htim, TIM_CHANNEL_2);
	  HAL_TIMEx_OCN_Start(&htim, TIM_CHANNEL_2);

	  sConfigOC.Pulse = timerPeriod / 2 - 1;
	  HAL_TIM_OC_ConfigChannel(&htim, &sConfigOC, TIM_CHANNEL_3);
	  HAL_TIM_OC_Start(&htim, TIM_CHANNEL_3);
	  HAL_TIMEx_OCN_Start(&htim, TIM_CHANNEL_3);*/

	}else{
	  // start
	  HAL_TIM_Base_Start_IT(&htim);
	}

}

//Convert note number to frequency
float NoteConvert(uint16_t noteNum){
	int64_t tmp = noteNum - 69;
	double exp = (double)tmp / 12.0;
	double freq = 440 * pow(2.0, exp);
	return (float)freq;
}

//Serial interrupt
void HAL_UART_RxCpltCallback(UART_HandleTypeDef *huart)
{
	static uint8_t event = 0;
	static uint8_t part = 0;

	//whether data header or data body
	if(uartCnt){
		if(part < TimerNum){
			notes[part] = data[0];
			freqs[part] = noteParFreq[notes[part]];
			//double the frequency if it is floppy, stp motor, or guitar
			freqs[part] *= 2;
			setTimer(part, times[part], (timer_clock / (freqs[part] * timerPeriod) - 1),70);
		}else if(part < TimerNum + RelayNum){
			HAL_GPIO_TogglePin(relayPort[part - TimerNum], relayPin[part - TimerNum]);
		}
		uartCnt = 0;
	}else{
		event = data[0] & 0xf0;
		part = data[0] & 0x0f;
		if(event){
			//note On
			uartCnt++;
		}else{
			//note Off
			//reset value
			notes[part] = 0;
			freqs[part] = 0;
			if(part < TimerNum){
				if(part < 1){
					//reset Timer of melody(stp motor)
					HAL_TIM_PWM_Stop(&times[part], TIM_CHANNEL_1);
				}else{
					//reset timer of solenoid and floppy
					HAL_TIM_Base_Stop_IT(&times[part]);
				}
			}
		}
	}
	//next data
	HAL_UART_Receive_IT(&huart2, (uint8_t *)data, 1);
}


/* USER CODE END 0 */

/**
  * @brief  The application entry point.
  * @retval int
  */
int main(void)
{
  /* MCU Configuration--------------------------------------------------------*/

  /* Reset of all peripherals, Initializes the Flash interface and the Systick. */
  HAL_Init();

  /* Configure the system clock */
  SystemClock_Config();

  /* Initialize all configured peripherals */
  MX_GPIO_Init();
  MX_USART2_UART_Init();
  MX_TIM1_Init();
  MX_TIM6_Init();
  MX_TIM7_Init();
  MX_TIM17_Init();
  MX_TIM2_Init();
  MX_TIM3_Init();
  MX_TIM15_Init();
  MX_TIM16_Init();
  /* USER CODE BEGIN 2 */

  //floppy1 --> 0 : direction, 1 : step
  //floppy2 --> 2 : direction, 3 : step
  floppyPort[0] = Direction1_GPIO_Port;
  floppyPort[1] = Step1_GPIO_Port;
  floppyPort[2] = Direction2_GPIO_Port;
  floppyPort[3] = Step2_GPIO_Port;
  floppyPin[0] = Direction1_Pin;
  floppyPin[1] = Step1_Pin;
  floppyPin[2] = Direction2_Pin;
  floppyPin[3] = Step2_Pin;
  relayPort[0] = Relay1_GPIO_Port;
  relayPort[1] = Relay2_GPIO_Port;
  relayPort[2] = Relay3_GPIO_Port;
  relayPort[3] = Relay4_GPIO_Port;
  relayPin[0] = Relay1_Pin;
  relayPin[1] = Relay2_Pin;
  relayPin[2] = Relay3_Pin;
  relayPin[3] = Relay4_Pin;
  guitarPort[0] = Guitar1_GPIO_Port;
  guitarPort[1] = Guitar2_GPIO_Port;
  guitarPort[2] = Guitar3_GPIO_Port;
  guitarPort[3] = Guitar4_GPIO_Port;
  guitarPort[4] = Guitar5_GPIO_Port;
  guitarPort[5] = Guitar6_GPIO_Port;
  guitarPin[0] = Guitar1_Pin;
  guitarPin[1] = Guitar2_Pin;
  guitarPin[2] = Guitar3_Pin;
  guitarPin[3] = Guitar4_Pin;
  guitarPin[4] = Guitar5_Pin;
  guitarPin[5] = Guitar6_Pin;

  for(uint8_t i = 0; i < RelayNum; i++){
	  HAL_GPIO_WritePin(relayPort[i], relayPin[i], GPIO_PIN_RESET);
  }
  for(uint8_t i = 0; i < FloppyNum * 2; i++){
	  HAL_GPIO_WritePin(floppyPort[i], floppyPin[i], GPIO_PIN_RESET);
  }
  for(uint8_t i = 0; i < GuitarNum; i++){
  	HAL_GPIO_WritePin(guitarPort[i], guitarPin[i], GPIO_PIN_RESET);
  }

  //Melody by Solenoid and Stp_Motor
  times[0] = htim1;
  //Guitar by Solenoid
  times[1] = htim2;
  times[2] = htim3;
  times[3] = htim6;
  times[4] = htim7;
  times[5] = htim15;
  times[6] = htim16;
  //Base by FloppyDrive
  times[7] = htim17;

  //reset floppy
  resetStep();
  //start UART interrupt
  HAL_UART_Receive_IT(&huart2, (uint8_t *)data, 1);
  for(uint8_t i = 0; i < 127; i++){
  	noteParFreq[i] =  (uint16_t)NoteConvert(i);
  }
  /* USER CODE END 2 */

  /* Infinite loop */
  /* USER CODE BEGIN WHILE */
  while (1)
  {
    /* USER CODE END WHILE */

    /* USER CODE BEGIN 3 */
  }
  /* USER CODE END 3 */
}

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
