Jin-Neuron/EleMagHarmony/(commit log)

2020-04-07 非同期処理等
2020-10-02 ベータ版
2020-10-05 ベータ版v3.1
2021-04-11 タイマーの誤差修正
2021-04-14 TrackBarの追加
2021-04-17 バイナリ送信
2021-04-17 バイナリ送信完成版
2021-04-17 不具合修正
2022-10-07 '修正'
2022-11-16 ignoreの修正
2023-02-21 add Stm32Firm
2023-02-22 add timer and uart
2023-02-23 add Relay, Floppy, Solenoid
2023-03-02 Upgrade Timer and change form
2023-03-04 update timer and midi play
2023-03-06 prototype v2
2023-03-06 prototype v2.1
2023-04-01 Add Stepping Motor
2023-04-01 change Pin and Player UI
    [EleMagDriver.kicad_pcb, EleMagDriver.kicad_sch]
2023-04-01 edit circuit
    [EleMagDriver.kicad_sch]
2023-04-01 add dcdc converter
    [EleMagDriver.kicad_sch]
2023-04-01 change folder structure
    [EleMagDriver.kicad_pcb, EleMagDriver.kicad_sch]
2023-04-05 update Timer and bug fix
2023-04-09 add cad data
    [EleMagDriver-B_Cu.gbr, EleMagDriver-B_Mask.gbr, EleMagDriver-B_Paste.gbr, EleMagDriver-B_Silkscreen.gbr, EleMagDriver-Edge_Cuts.gbr, EleMagDriver-F_Cu.gbr, EleMagDriver-F_Mask.gbr, EleMagDriver-F_Paste.gbr]
2023-04-18 add Garber
    [EleMagDriver-B_Cu.gbr, EleMagDriver-B_Mask.gbr, EleMagDriver-B_Paste.gbr, EleMagDriver-B_Silkscreen.gbr, EleMagDriver-Edge_Cuts.gbr, EleMagDriver-F_Cu.gbr, EleMagDriver-F_Mask.gbr, EleMagDriver-F_Paste.gbr]
2023-08-28 add SoundLevelMater
    [EleMagDriver.kicad_sch, SoundLevelMater.kicad_pcb, SoundLevelMater.kicad_sch]
2023-09-30 add guitar and more
    [EleMagDriver.kicad_sch]
2023-10-01 substrate add guitar and more
    [EleMagDriver.kicad_pcb, EleMagDriver.kicad_sch]
2023-10-01 fix tempo bug
    [EleMagDriver-B_Cu.gbr, EleMagDriver-B_Mask.gbr, EleMagDriver-B_Paste.gbr, EleMagDriver-B_Silkscreen.gbr, EleMagDriver-Edge_Cuts.gbr, EleMagDriver-F_Cu.gbr, EleMagDriver-F_Mask.gbr, EleMagDriver-F_Paste.gbr]
2023-10-03 change stepping motor line
    [EleMagDriver-B_Cu.gbr, EleMagDriver-B_Mask.gbr, EleMagDriver-B_Paste.gbr, EleMagDriver-B_Silkscreen.gbr, EleMagDriver-Edge_Cuts.gbr, EleMagDriver-F_Cu.gbr, EleMagDriver-F_Mask.gbr, EleMagDriver-F_Paste.gbr]
2023-10-04 add solenoid mount of guitar
    [SolenoidMount.stl]
